Moisschen/js-keypad/(commit log)

2026-10-02 JS-Keypad: Firmware fuer 12 Tasten + Stick und Web-Mapper mit klickbarem Abbild
2026-10-02 Visueller Verdrahtungsplan (DE/EN) auf der Seite und in der README, Jasp-Hinweis aus der README entfernt
2026-10-02 Daumentaste unter dem Stick (Pin 15): Firmware 1.1, Mapper, Verdrahtungsplan
    Pin 15 war als Kalibrier-Taster ausgewertet; Kalibrierung laeuft nur noch ueber den Mapper.
2026-10-02 Mapper: echte Draufsicht des Geraets (aus den Druckteilen), gedrehte Spalte kleiner Finger
    tools/make_outline.py projiziert die Druckteile von oben und berechnet die Tastenkappen wie main.scad.
2026-10-02 Draufsicht: Palmrest liegt ueber Joystick-Aufnahme und Oberschale
2026-10-02 Draufsicht: Umriss der Oberschale geglaettet (keine Zacke an der Hinterkante)
2026-10-02 Draufsicht: Stick-Feld direkt auf der Joystick-Aufnahme, Stick-Scheibe und Hinweislinie entfernt
2026-10-02 Draufsicht: Stick-Feld 10 mm tiefer
2026-10-02 Firmware 1.2: Verdrahtung anlernen (PINS) und Stick abschaltbar (STICK); Mapper mit Anlern-Assistent
2026-10-02 Firmware 1.3: Stick-Achsen umkehrbar (INV), auch fuer die Einsteck-Gesten; Mapper-Schalter
2026-10-03 Verdrahtungsplan: Pro Micro von unten, tatsaechliche Tasten-Pins, Stick als PS5-Hall-Modul mit allen Anschluessen
2026-10-03 Mapper: Verdrahtungsplan mit Kennung im Link, damit der Browser nach Aenderungen nicht den alten zeigt
